f1rmb/aWXIrons/doxygen/myHeader.tex

\documentclass[twoside]{book}

% Packages required by doxygen
\usepackage{calc}
\usepackage{doxygen}
\usepackage{graphicx}
\usepackage[utf8]{inputenc}
\usepackage{makeidx}
\usepackage{multicol}
\usepackage{multirow}
\usepackage{textcomp}
\usepackage[table]{xcolor}

% Font selection
\usepackage[T1]{fontenc}
\usepackage{mathptmx}
\usepackage[scaled=.90]{helvet}
\usepackage{courier}
\usepackage{amssymb}
\usepackage{sectsty}
\renewcommand{\familydefault}{\sfdefault}
\allsectionsfont{%
  \fontseries{bc}\selectfont%
  \color{darkgray}%
}
\renewcommand{\DoxyLabelFont}{%
  \fontseries{bc}\selectfont%
  \color{darkgray}%
}

% Page & text layout
\usepackage{geometry}
\geometry{%
  a4paper,%
  top=2.5cm,%
  bottom=2.5cm,%
  left=2.5cm,%
  right=2.5cm%
}
\tolerance=750
\hfuzz=15pt
\hbadness=750
\setlength{\emergencystretch}{15pt}
\setlength{\parindent}{0cm}
\setlength{\parskip}{0.2cm}
\makeatletter
\renewcommand{\paragraph}{%
  \@startsection{paragraph}{4}{0ex}{-1.0ex}{1.0ex}{%
    \normalfont\normalsize\bfseries\SS@parafont%
  }%
}
\renewcommand{\subparagraph}{%
  \@startsection{subparagraph}{5}{0ex}{-1.0ex}{1.0ex}{%
    \normalfont\normalsize\bfseries\SS@subparafont%
  }%
}
\makeatother

% Headers & footers
\usepackage{fancyhdr}
\pagestyle{fancyplain}
\fancyhead[LE]{\fancyplain{}{\bfseries\thepage}}
\fancyhead[CE]{\fancyplain{}{}}
\fancyhead[RE]{\fancyplain{}{\bfseries\leftmark}}
\fancyhead[LO]{\fancyplain{}{\bfseries\rightmark}}
\fancyhead[CO]{\fancyplain{}{}}
\fancyhead[RO]{\fancyplain{}{\bfseries\thepage}}
\fancyfoot[LE]{\fancyplain{}{}}
\fancyfoot[CE]{\fancyplain{}{}}
\fancyfoot[RE]{\fancyplain{}{\bfseries\scriptsize User and Programmer Manual for aWXIron 1.\-4, written by F1RMB Daniel Caujolle-Bert \copyright 2015 }}
\fancyfoot[LO]{\fancyplain{}{\bfseries\scriptsize User and Programmer Manual for aWXIron 1.\-4, written by F1RMB Daniel Caujolle-Bert \copyright 2015 }}
\fancyfoot[CO]{\fancyplain{}{}}
\fancyfoot[RO]{\fancyplain{}{}}
\renewcommand{\footrulewidth}{0.4pt}
\renewcommand{\chaptermark}[1]{%
  \markboth{#1}{}%
}
\renewcommand{\sectionmark}[1]{%
  \markright{\thesection\ #1}%
}

% Indices & bibliography
\usepackage{natbib}
\usepackage[titles]{tocloft}
\setcounter{tocdepth}{3}
\setcounter{secnumdepth}{5}
\makeindex

% Hyperlinks (required, but should be loaded last)
\usepackage{ifpdf}
\ifpdf
  \usepackage[pdftex,pagebackref=true]{hyperref}
\else
  \usepackage[ps2pdf,pagebackref=true]{hyperref}
\fi
\hypersetup{%
  colorlinks=true,%
  linkcolor=blue,%
  citecolor=blue,%
  unicode%
}

% Custom commands
\newcommand{\clearemptydoublepage}{%
  \newpage{\pagestyle{empty}\cleardoublepage}%
}

%===== C O N T E N T S =====

\begin{document}

% Titlepage & ToC
\hypersetup{pageanchor=false}
\pagenumbering{roman}
\begin{titlepage}
\vspace*{7cm}
\begin{center}%
{\Large Manual for a\-W\-X\-Iron \\[1ex]\large 1.\-4 }\\
\vspace*{1cm}
{\large Written by F1RMB, Daniel Caujolle-Bert \copyright 2015 }\\
\vspace*{1cm}
\end{center}
\end{titlepage}
\clearemptydoublepage
\tableofcontents
\clearemptydoublepage
\pagenumbering{arabic}
\hypersetup{pageanchor=true}

%--- Begin generated contents ---
\chapter{S\-M\-D Soldering Station for Weller R\-T Series Tips}
\label{mainpage}
\hypertarget{mainpage}{}
\input{mainpage}
\chapter{User Interface overview}
\label{_u_i}
\hypertarget{_u_i}{}
\input{_u_i}
\chapter{Calibration Process}
\label{cal}
\hypertarget{cal}{}
\input{cal}
\chapter{Class Index}
\input{annotated}
\chapter{File Index}
\input{files}
\chapter{Class Documentation}
\input{uniona_d_s_channels_1_1__eeprom_calibration_value__t}
\input{classa_d_s_channel}
\input{classa_d_s_channels}
\input{classa_d_s_engine}
\input{structa_d_s_channel_1_1a_pin__t}
\input{structa_d_s_channel_1_1_calibration_data__t}
\chapter{File Documentation}
\input{a_d_s_engine_8cpp}
\input{a_d_s_engine_8h}
\input{_c_d_c_8cpp}
\input{_hardware_serial_8cpp}
\input{_h_i_d_8cpp}
\input{_i_p_address_8cpp}
\input{libraries_8cpp}
\input{main_8cpp}
\input{new_8cpp}
\input{_print_8cpp}
\input{sketch_8cpp}
\input{_stream_8cpp}
\input{_tone_8cpp}
\input{_u_s_b_core_8cpp}
\input{_w_interrupts_8c}
\input{wiring_8c}
\input{wiring__analog_8c}
\input{wiring__digital_8c}
\input{wiring__pulse_8c}
\input{wiring__shift_8c}
\input{_w_math_8cpp}
\input{_w_string_8cpp}
%--- End generated contents ---

% Index
\newpage
\phantomsection
\addcontentsline{toc}{chapter}{Index}
\printindex

\end{document}
