f1rmb/aWXIrons/eagle/aWXIrons/Overview.png

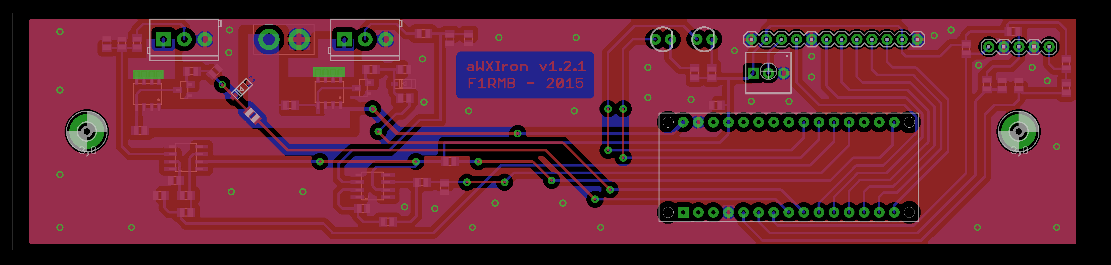
eagle/aWXIrons/Overview.png
