f1rmb/aWXIrons/doc/aWXIronsCalibration.ods

Sheet: Channel 1
~Temp setting | Temp. °C | ADCread
160 | 104.6 | 160
280 | 158 | 280
380 | 201.2 | 380
500 | 247 | 500
680 | 301.7 | 680
880 | 377.5 | 880
999 | 430 | 999
 |  |  | Slope = | 0.3757498594 |  | Offset = | 51.7808993467
 |  |  | Calibration String = |  | :CAL:1:0.3757498594,51.7808993467

Sheet: Channel 2
~Temp setting | Temp. °C | ADCread
160 | 113.1 | 160
280 | 164.2 | 280
380 | 204 | 380
500 | 247.4 | 500
680 | 308 | 680
880 | 377.7 | 880
999 | 422 | 999
 |  |  | Slope = | 0.3615983882 |  | Offset = | 61.9656931895
 |  |  | Calibration String = |  | :CAL:2:0.3615983882,61.9656931895

Sheet: Channel 1 30-01-17
~Temp setting | Temp. °C | ADCread
160 | 115 | 160
280 | 159 | 280
380 | 207 | 380
500 | 254 | 500
680 | 323 | 680
880 | 393 | 880
999 | 432 | 999
 |  |  | Slope = | 0.3806480841 |  | Offset = | 58.0665831083
 |  |  | Calibration String = |  | :CAL:1:0.3806480841,58.0665831083
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
