f1rmb/aWXIrons/eagle/aWXIrons/ComponentsBottom.pdf

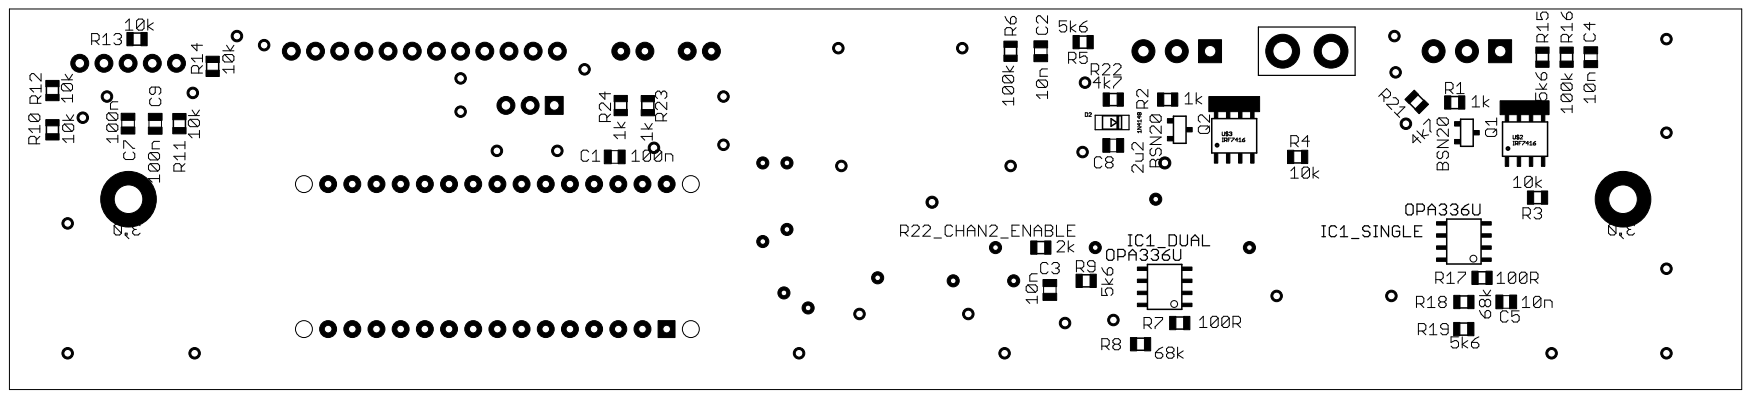
[picture p2: page 1]
