f1rmb/aWXIrons/eagle/aWXIrons/ComponentsTop.pdf

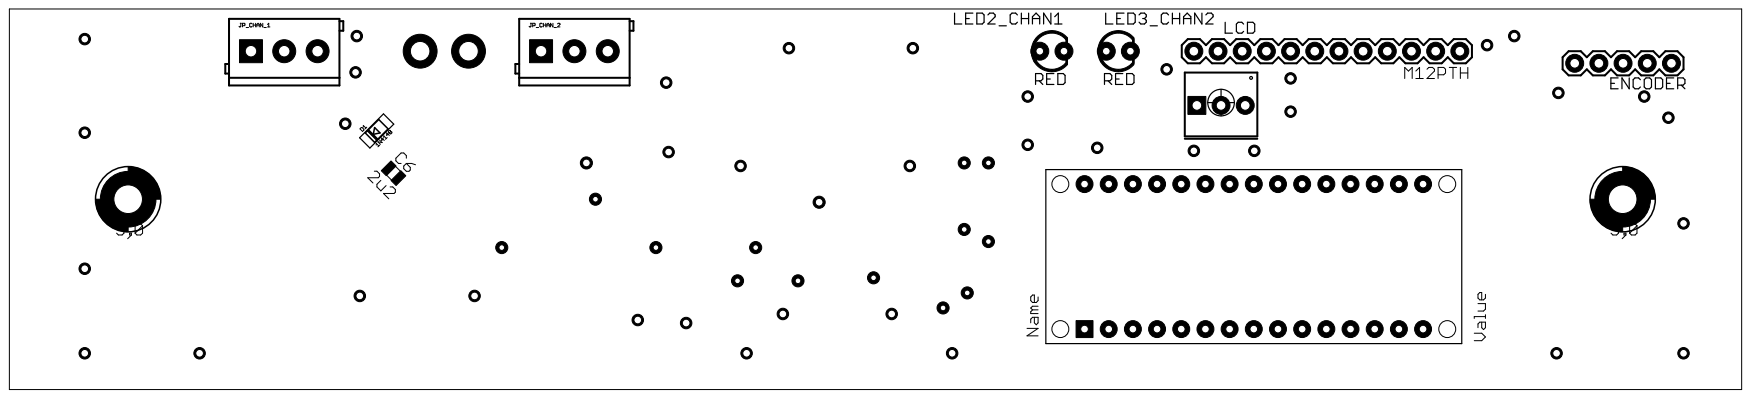
[picture p3: page 1]
