f1rmb/aWXIrons/eagle/aWXIrons/schematic.pdf

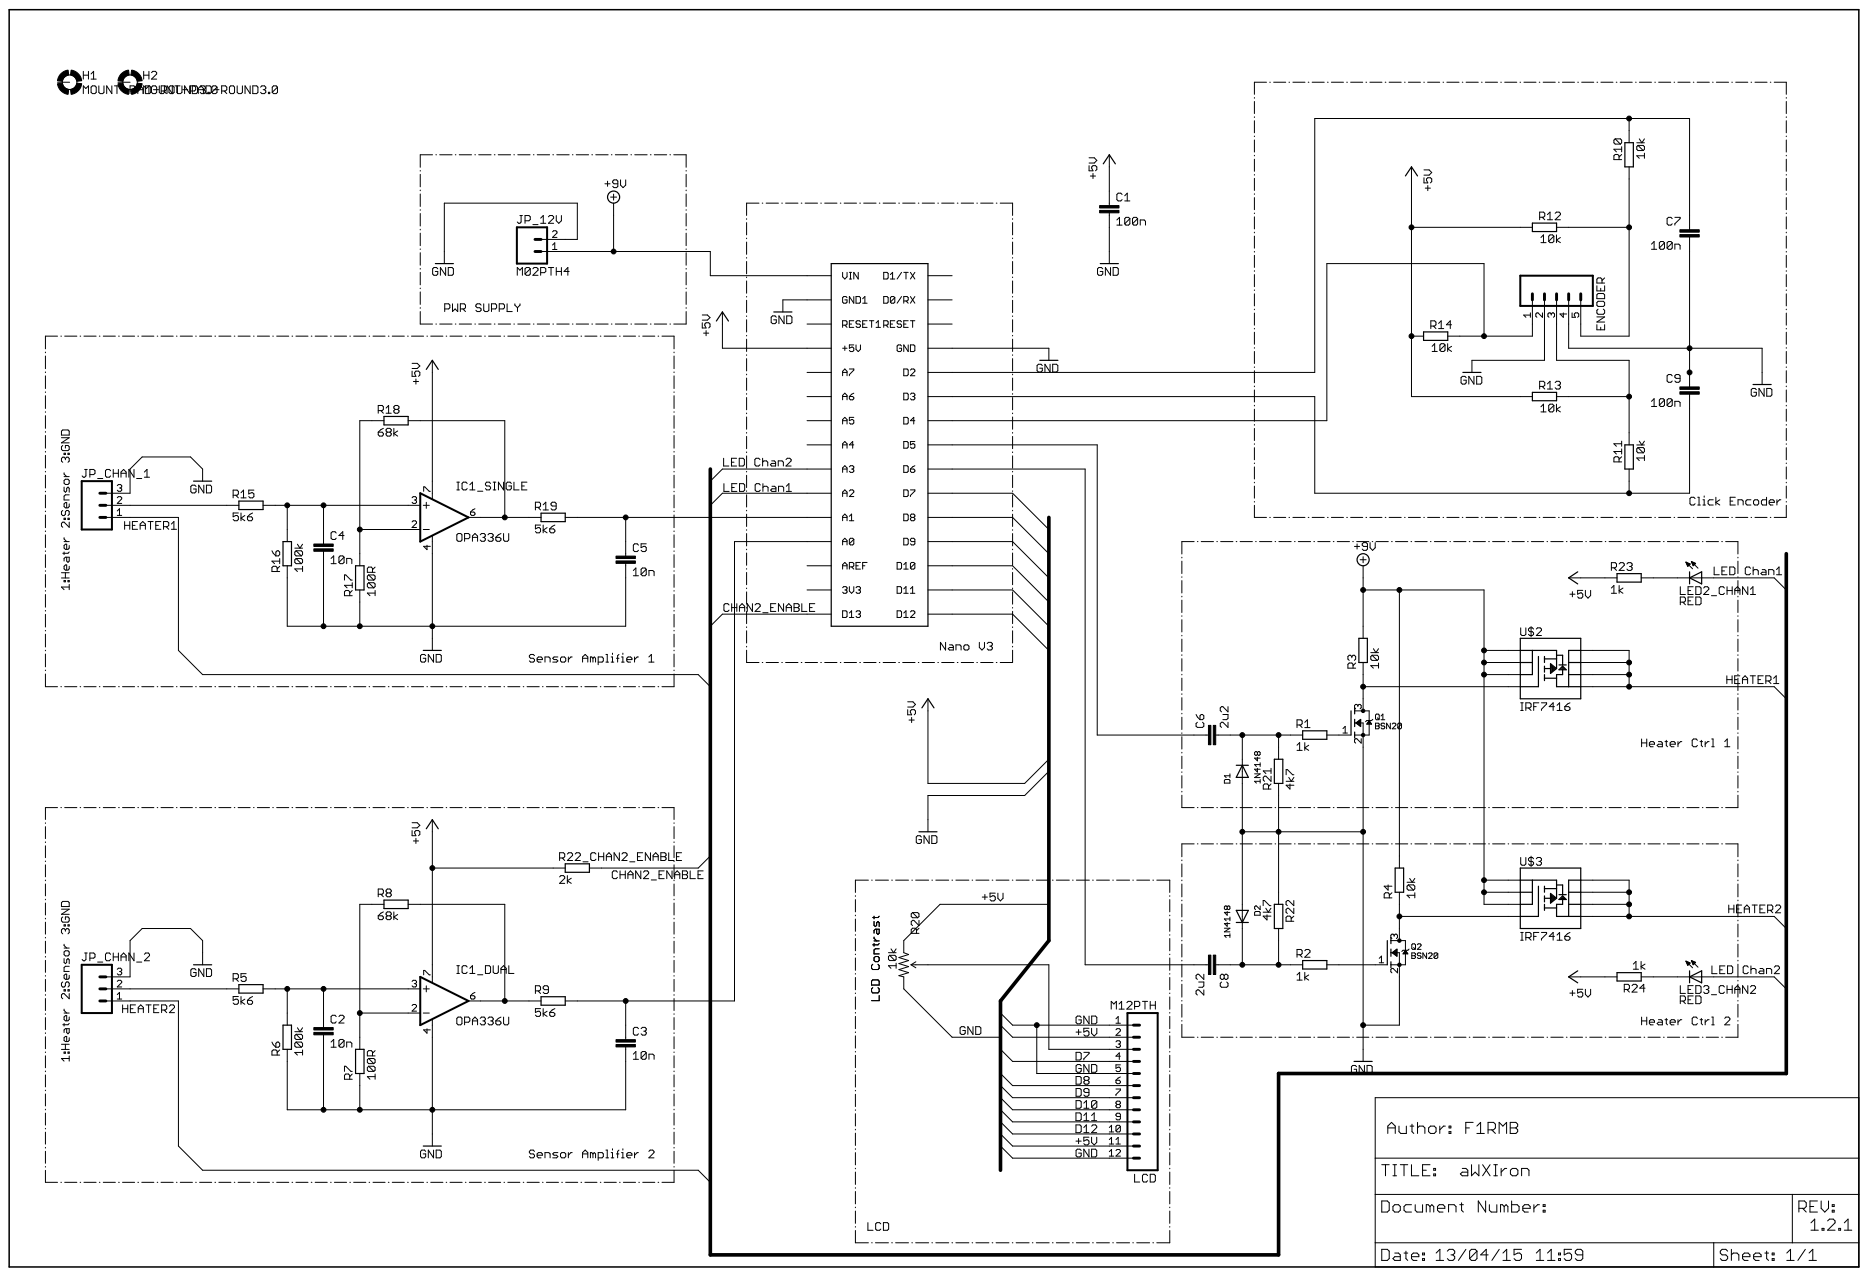
[picture p4: page 1]
