f1rmb/aWXIrons/eagle/aWXIrons/BottomSide.pdf

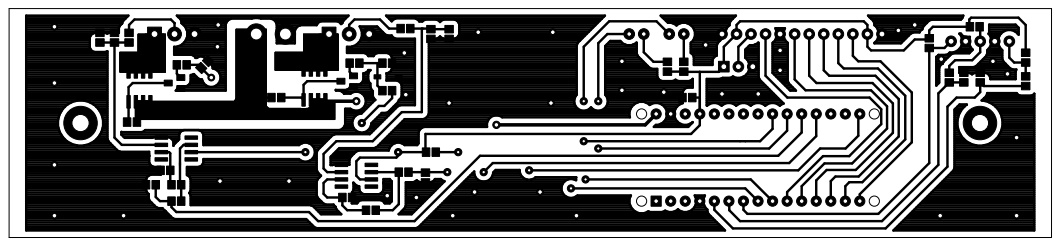
[picture p5: page 1]
