f1rmb/aWXIrons/eagle/aWXIrons/TopSide.pdf

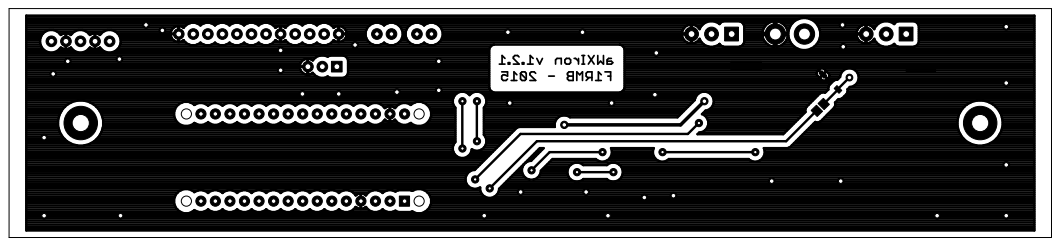
[picture p6: page 1]
