f1rmb/aWXIrons/eagle/aWXIrons/main.brd

## EAGLE design eagle/aWXIrons/main.brd (2015-04-13)

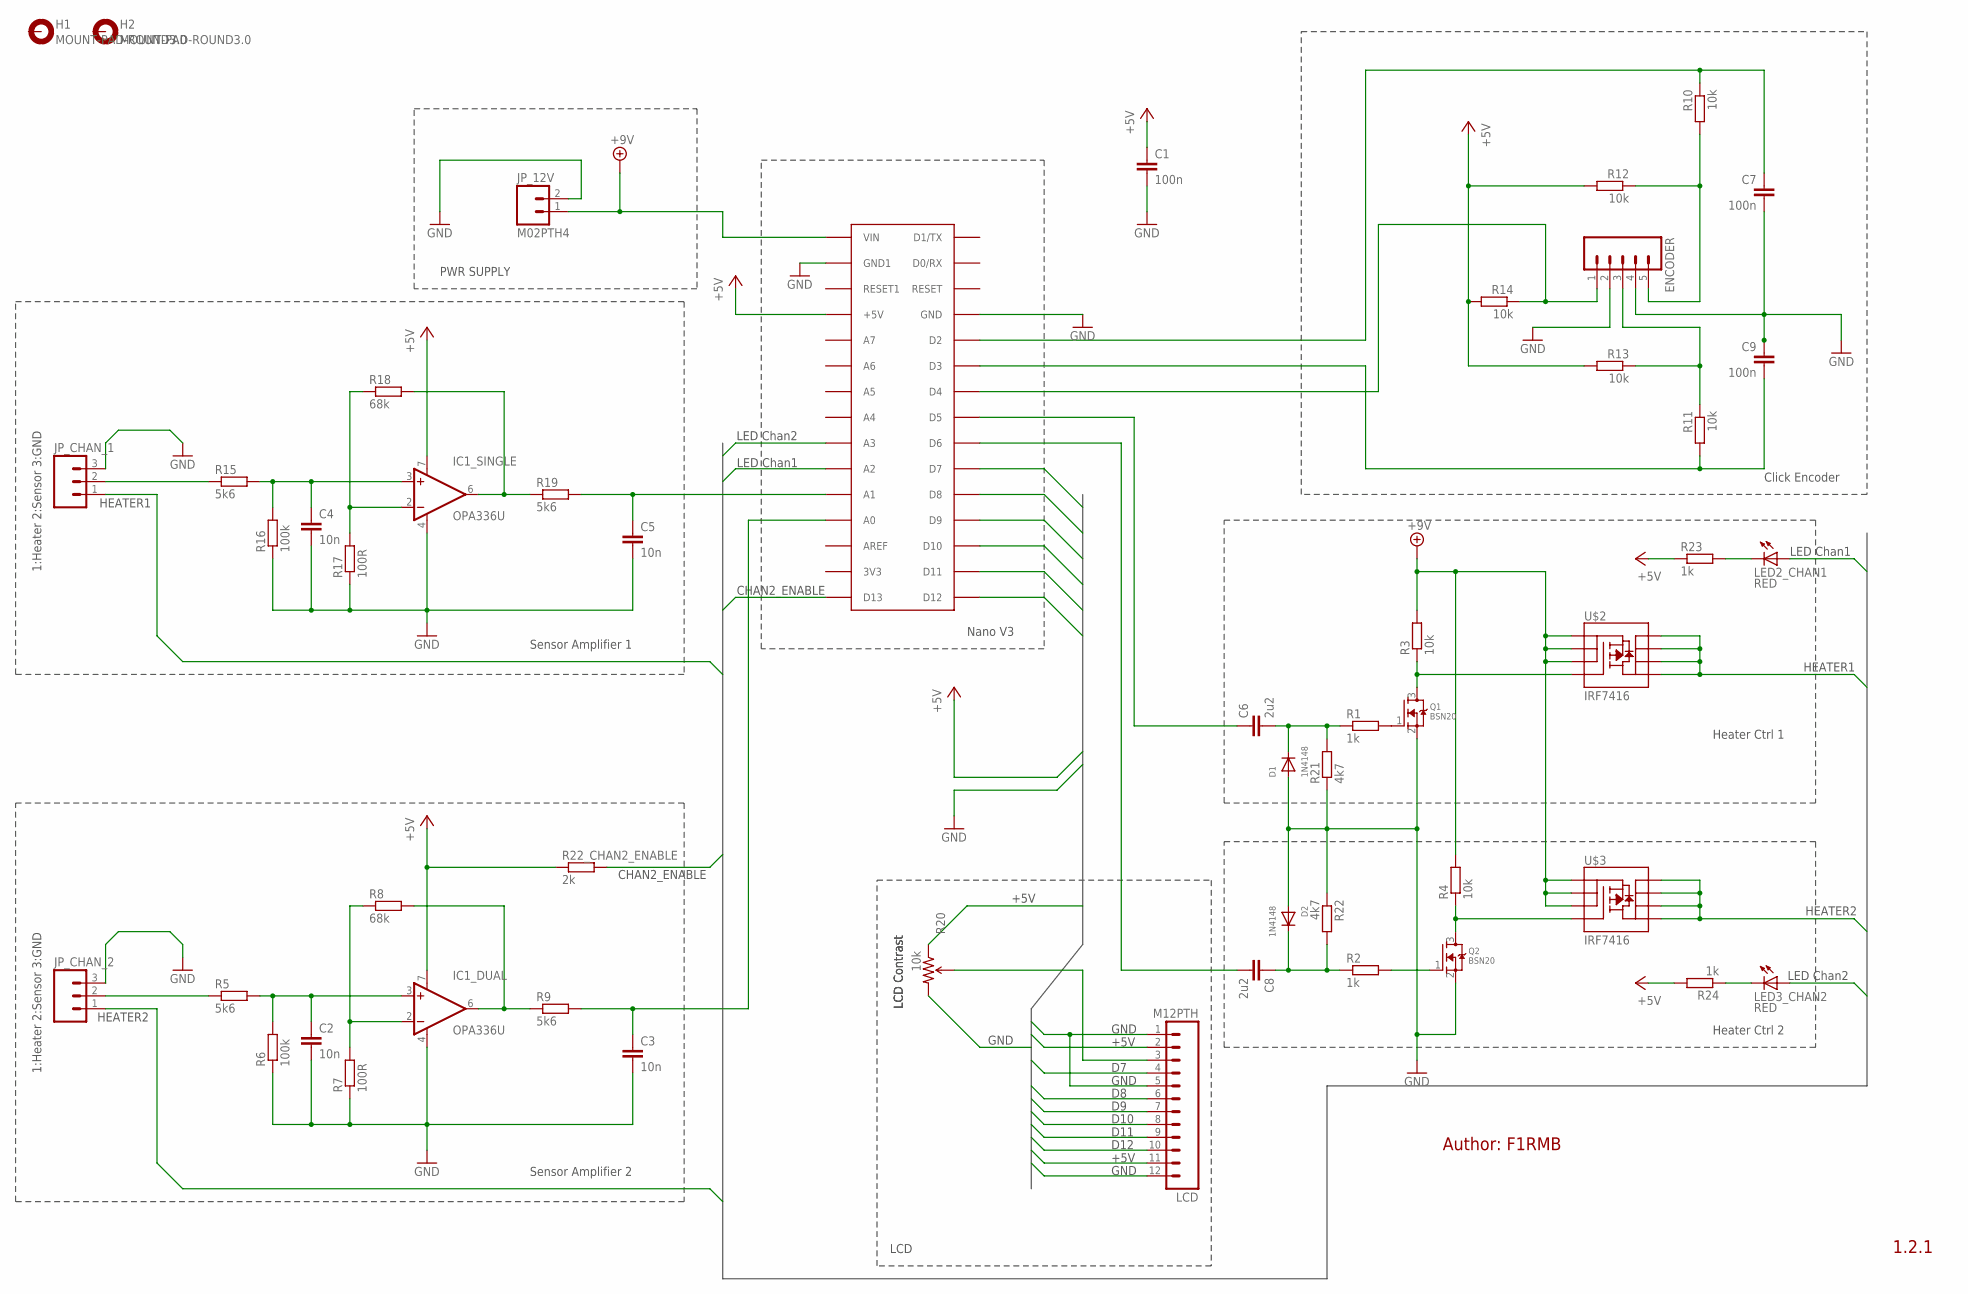
[picture p7: schematic main.sch]

Parts:
C1, C7, C9: 100n; C0805
C2, C3, C4, C5: 10n; C0805
C6, C8: 2u2; C0805
D1, D2: 1N4148; SOD-123
ENCODER: M05PTH; 1X05
H1, H2: MOUNT-PAD-ROUND3.0; 3,0-PAD
IC1_DUAL, IC1_SINGLE: OPA336U; SO08
JP_12V: M02PTH4; 1X02_XTRA_BIG
JP_CHAN_1, JP_CHAN_2: M03SCREW; SCREWTERMINAL-3.5MM-3
LCD: M12PTH; 1X12
LED2_CHAN1, LED3_CHAN2: RED; LED3MM
Q1, Q2: BSN20; SOT23
R1, R2, R23, R24: 1k; R0805
R3, R4, R10, R11, R12, R13, R14: 10k; R0805
R5, R9, R15, R19: 5k6; R0805
R6, R16: 100k; R0805
R7, R17: 100R; R0805
R8, R18: 68k; R0805
R20: 10k; 3362U-2
R21, R22: 4k7; R0805
R22_CHAN2_ENABLE: 2k; R0805
U$1: ARDUINONANO; PDIP-32
U$2, U$3: IRF7416; SO08

Connections:
+5V: C1.1, IC1_DUAL.7 (V+), IC1_SINGLE.7 (V+), LCD.2, LCD.11, R12.2, R13.2, R14.2, R20.1 (CCW), R22_CHAN2_ENABLE.1, R23.1, R24.2, U$1.+5V
+9V: JP_12V.1, R3.2, R4.2, U$1.VIN, U$2.1 (S), U$2.2 (S), U$2.3 (S), U$3.1 (S), U$3.2 (S), U$3.3 (S)
DB4: LCD.7, U$1.D9
DB5: LCD.8, U$1.D10
DB6: LCD.9, U$1.D11
DB7: LCD.10, U$1.D12
E: LCD.6, U$1.D8
ENABLECHAN2: R22_CHAN2_ENABLE.2, U$1.D13
GND: C1.2, C2.2, C3.2, C4.2, C5.2, C7.2, C9.1, D1.A, D2.A, ENCODER.2, ENCODER.4, IC1_DUAL.4 (V-), IC1_SINGLE.4 (V-), JP_12V.2, JP_CHAN_1.3, JP_CHAN_2.3, LCD.1, LCD.5, LCD.12, Q1.2 (S), Q2.2 (S), R6.1, R7.1, R16.1, R17.1, R20.3 (CW), R21.1, R22.1, U$1.GND, U$1.GND1
HEATCHAN1: LED2_CHAN1.A, U$1.A2
HEATCHAN2: LED3_CHAN2.A, U$1.A3
HEATER1: JP_CHAN_1.1, U$2.5 (D), U$2.6 (D), U$2.7 (D), U$2.8 (D)
HEATER2: JP_CHAN_2.1, U$3.5 (D), U$3.6 (D), U$3.7 (D), U$3.8 (D)
unnamed: Q1.3 (D), R3.1, U$2.4 (G)
unnamed: Q2.3 (D), R4.1, U$3.4 (G)
unnamed: JP_CHAN_2.2, R5.1
unnamed: C2.1, IC1_DUAL.3 (+IN), R5.2, R6.2
unnamed: IC1_DUAL.2 (-IN), R7.2, R8.1
unnamed: C7.1, R10.1, U$1.D2
unnamed: IC1_DUAL.6 (OUT), R8.2, R9.1
unnamed: JP_CHAN_1.2, R15.1
unnamed: C4.1, IC1_SINGLE.3 (+IN), R15.2, R16.2
unnamed: C6.1, U$1.D5
unnamed: C8.2, U$1.D6
unnamed: Q1.1 (G), R1.2
unnamed: Q2.1 (G), R2.2
unnamed: C3.1, R9.2, U$1.A0
unnamed: ENCODER.5, R10.2, R12.1
unnamed: LCD.3, R20.2 (WIPER)
unnamed: C6.2, D1.C, R1.1, R21.2
unnamed: ENCODER.3, R11.1, R13.1
unnamed: C9.2, R11.2, U$1.D3
unnamed: IC1_SINGLE.2 (-IN), R17.2, R18.1
unnamed: IC1_SINGLE.6 (OUT), R18.2, R19.1
unnamed: ENCODER.1, R14.1, U$1.D4
unnamed: C5.1, R19.2, U$1.A1
unnamed: C8.1, D2.C, R2.1, R22.2
unnamed: LED2_CHAN1.K (C), R23.2
unnamed: LED3_CHAN2.K (C), R24.1
RS: LCD.4, U$1.D7

Notes on the sheet:
1:Heater 2:Sensor 3:GND
PWR SUPPLY
LCD
Nano V3
Click Encoder
Sensor Amplifier 1
Sensor Amplifier 2
Heater Ctrl 1
Heater Ctrl 2
LED Chan1
LED Chan2
LCD Contrast
1.2.1
Author: F1RMB
CHAN2_ENABLE
+5V
GND
D10
D11
D12
HEATER1
HEATER2

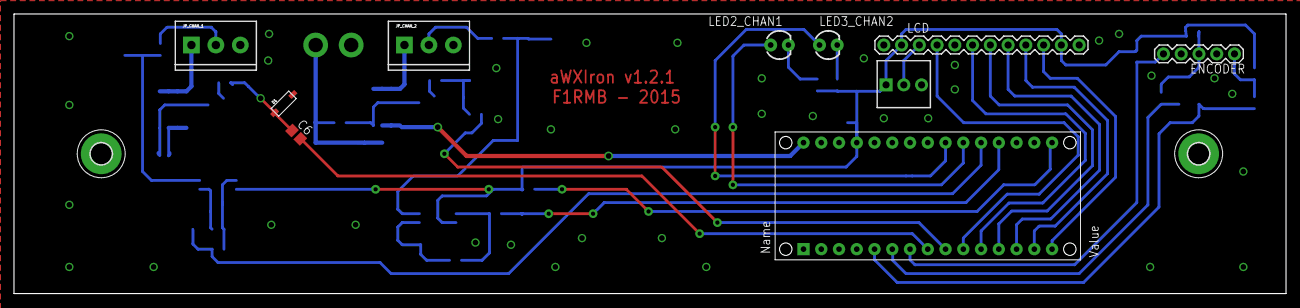
[picture p8: board main.brd from above]

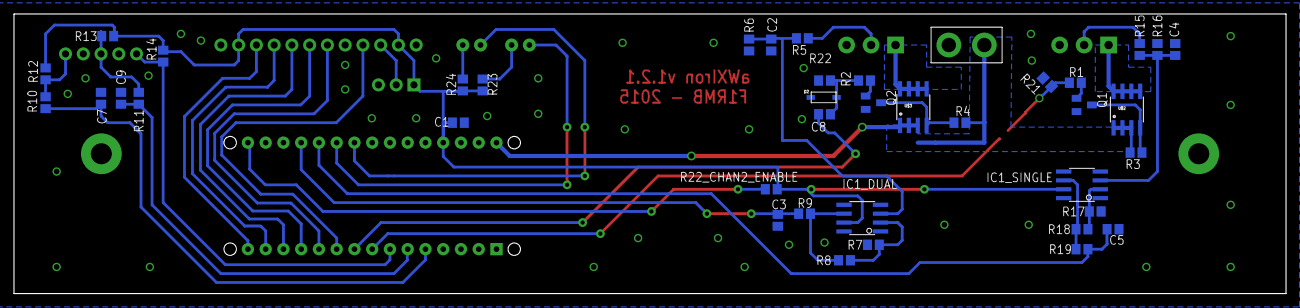
[picture p9: board main.brd from below]

Board: 2 copper layers, 182.0 x 40.0 mm, 52 parts (40 on the bottom side), 40 nets.
