f1rmb/aWXIrons/(commit log)

2015-03-29 First Import.
    [main.brd, main.sch]
2015-03-31 Finalize Makefile. Update doc (unfinished). Turn both channels PWM off while reading ADC. Add plugged tip detection (display shows '---' when unplugged). In joined channels mode, temperature display 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
2015-04-05 Finalize documentation. Fix calibration process.
    [aWXIronsCalibration.ods]
2015-04-13 - Displayed temperature is averaged. - Fix documentation (F6AZZ). - Bump version, update user manual.
2015-04-13 Revert "- Displayed temperature is averaged."
    This reverts commit 4ef88245852de1e1e4a668eb0dcc3ed734a76e18.
2015-04-13 - Displayed temperature is now averaged. - Fix documentation (F6AZZ). - Bump version, update user manual. - New release.
    [aDSEngine.cpp, aDSEngine.h]
2015-04-13 Change +12V to +9V in schematic and PCBs. Update PDFs.
    [main.brd, main.sch]
2016-03-10 Fix small if statement error (not critical). Bump version number. New HEX file.
    [aDSEngine.cpp, aDSEngine.h]
2017-01-29 Fix averaging class, stupid me... Bump version.
    [aDSEngine.cpp, aDSEngine.h]
2017-01-29 :CAL:DUMP displays EEPROM calibration values. Update copyright year. More cleanup.
2017-01-30 Reintroduce averaging made of double values. Use and fix usage of strcmp_P and snprintf_P. Update doc. Release.
    [aWXIronsCalibration.ods]
2017-08-21 Make it compile on 'standard' arduino install (in /opt/arduino).
