f1rmb/aWXIrons/(notices)

Notices in the files:
cores/wiring.c:
Public License along with this library; if not, write to the
Free Software Foundation, Inc., 59 Temple Place, Suite 330,
Boston, MA 02111-1307 USA
parts and their libraries:
SparkFun-Electromechanical: Licensing: Creative Commons ShareAlike 4.0 International - https://creativecommons.org/licenses/by-sa/4.0
